The-Penn-State-Behrend-Robotics-Club/ChalkbotMechanical/Chalkbot1.0/Apparatus/V3/Other Docs/Parts and Price List.xlsx

Stepper Apparatus
 | Item | Price/Unit | MIN Req. Units | Total Price | Link | Comments
 | 550 Type III Paracord | $7.02 | 1 | $7.02 | Amazon Basics 550 Type III Paracord, 7-Strand Core, High Strength - 5/32 Inch x 100 Foot (4mm x 30m), Blue - - Amazon.com (https://www.amazon.com/Amazon-Basics-Paracord-7-Strand-Strength/dp/B08HNZCH3Z) | Nothing special about that specific link other than it is cheap. 550 Type III prefered for its dimensions, but it is overkill strength wise. If it can be seen, multiple colors may be fun.
 | 20 Pulleys | $9.71 | 1 | $9.71 | Amazon.com: Chiloskit 20pcs 1.5mm Deep Metal V Groove Guide Pulley Bearing Wheel Rail Ball Bearings Wheel 4x13x6mm : Industrial & Scientific (https://www.amazon.com/gp/product/B012KKTBRU/ref=ppx_yo_dt_b_search_asin_title?ie=UTF8&psc=1) | I already have 20 of these
 | 17HS19-2004S1 59 Ncm NEMA 17 Stepper Motor | $13.99 | 8 | $111.92 | STEPPERONLINE Nema 17 Stepper Motor Bipolar 2A 59Ncm(84oz.in) 48mm Body 4-lead W/ 1m Cable and Connector compatible with 3D Printer/CNC - - Amazon.com (https://www.amazon.com/STEPPERONLINE-Stepper-Bipolar-Connector-compatible/dp/B00PNEQKC0?s=hi) | All testing was done with a 59Ncm stepper. On paper, much less torque is needed (about 10.7 Ncm for pulling NOT HOLDING), but math does not not line up with real world application. May also be cheaper elsewhere.
 | Stepper Motor Drivers (4 pack) | $11.49 | 2 | $22.98 | Amazon.com: HiLetgo 4pcs L298N Motor Driver Controller Board Module Stepper Motor DC Dual H-Bridge for Arduino Smart Car Power UNO MEGA R3 Mega2560 : Industrial & Scientific (https://www.amazon.com/HiLetgo-Controller-Stepper-H-Bridge-Mega2560/dp/B07BK1QL5T?s=industrial) | Don't know if these are best/good, but are what I used. I have 1 pack of 4.
Either | LCF 025 05 031S (1.03 lb CF Spring) | $5.05 | 16 | $80.80 | Search for Constant Force Springs | Lee Spring (https://www.leespring.com/constant-force-springs) | For 2lb writing force. I already have 4 of these.
OR | LCF 040 04 025S (0.5 lb CF Spring) | $5.08 | 16 | $81.28 | Search for Constant Force Springs | Lee Spring (https://www.leespring.com/constant-force-springs) | For 1lb writing force. I already have 4 of these.
OR | LCF 130 06 038S (0.71 lb CF Spring) | $5.83 | 16 | $93.28 | Search for Constant Force Springs | Lee Spring (https://www.leespring.com/constant-force-springs) | For 1.42lb writing force.
OR | LCF 025 05 031S (1.03 lb CF Spring) And LCF 040 04 025S (0.5 lb CF Spring) | $5.06 | 16 | $81.04 | Search for Constant Force Springs | Lee Spring (https://www.leespring.com/constant-force-springs) | Priced out half 1lb and half 0.5 lb. Twisting when combining a 1.03 lb and a 0.5 lb spring is minimal and may be a viable solution if 1.53 lb is desired.
Either | ATOPLEE 10pcs Mini Electromagnetic Solenoid Lock DC 12V Slim Design Cabinet Drawer Lock,27X29X18mm | $39.99 | 1 | $39.99 | ATOPLEE 1pc Mini Electromagnetic Solenoid Lock DC 12V Slim Design Cabinet Drawer Lock,27X29X18mm - - Amazon.com (https://www.amazon.com/gp/product/B01FH5JUD0/ref=ppx_yo_dt_b_asin_title_o07_s00?ie=UTF8&th=1) | We only need 8, so 2 packs of 4 will work. I already have one of these. Essentially the same price as buying a pack of 10 though. I have no idea if 12V or 6V is better for our use, but the way I was powering it, the stepper used too much power to operate the 12V solenoid out of my power regulator.
OR | uxcell DC 6V 1A 6mm Mini Electromagnetic Solenoid Lock Assembly Tongue Up for Electirc Lock Cabinet Door Lock | $13.49 | 8 | $107.92 | uxcell DC 6V 1A 6mm Mini Electromagnetic Solenoid Lock Assembly Tongue Up for Electirc Lock Cabinet Door Lock: Amazon.com: Tools & Home Improvement (https://www.amazon.com/gp/product/B07TMVR312/ref=ppx_yo_dt_b_asin_title_o03_s00?ie=UTF8&psc=1) | I don’t know if we need 6V, but it is way more expensive… I have one of these.
Change to 8 on one board | Relays for Solenoids (10 pack) | $13.99 | 1 | $13.99 | ANMBEST 10PCS 12V Relay Module with Optocoupler High or Low Level Trigger Expansion Board for Raspberry Pi Arduino: Amazon.com: Industrial & Scientific (https://www.amazon.com/ANMBEST-Optocoupler-Trigger-Expansion-Raspberry/dp/B08PNHHC65?s=industrial) | Not sure if these are best. I used one of these or similar. There is also and eight channel one on one board.
 | 1 kg 3D Printer filament spool | $24.99 | 4 probably | #VALUE! | Amazon.com: HATCHBOX 1.75mm Black PLA 3D Printer Filament, 1 KG Spool, Dimensional Accuracy +/- 0.03 mm, 3D Printing Filament : Industrial & Scientific (https://www.amazon.com/dp/B00J0ECR5I) | This one is up to preference and price. Fun colors would be cool. The link is the filament I like, but whatever should work.
 | Total |  |  | $286.65 | not including filament cost, using price for half 1.03 lb and half 0.5 lb springs, and assuming 12V solenoids work.
 | Needs Fasteners
Linear Actuator Apparatus
 | Item | Price/Unit | MIN Req. Units | Total Price | Link | Comments
 | 550 Type III Paracord | $7.02 | 1 | $7.02 | Amazon Basics 550 Type III Paracord, 7-Strand Core, High Strength - 5/32 Inch x 100 Foot (4mm x 30m), Blue - - Amazon.com (https://www.amazon.com/Amazon-Basics-Paracord-7-Strand-Strength/dp/B08HNZCH3Z) | Nothing special about that specific link other than it is cheap. 550 Type III prefered for its dimensions, but it is overkill strength wise. If it can be seen, multiple colors may be fun.
 | UYGALAXY 4" Stroke Micro Electric Linear Actuator 12V - 32N/7.2lb Speed 1.2"/sec Mini Waterproof Metal Mini Motion Actuator with Mounting Bracket for DIY Robot Cabinet Drawer Shutter Cosplay | $39.99 | 8 | $319.92 | UYGALAXY 4" Stroke Micro Electric Linear Actuator 12V - 32N/7.2lb Speed 1.2"/sec Mini Waterproof Metal Mini Motion Actuator with Mounting Bracket for DIY Robot Cabinet Drawer Shutter Cosplay: Amazon.com: Industrial & Scientific (https://www.amazon.com/UYGALAXY-Stroke-Electric-Linear-Actuator/dp/B0B4BHRYMG?s=industrial) | Important part is 4 inch stroke and around 15N. Aavailability may be spotty and prices seem to only go up. Steppers are more consistent in price and stock.
 | Reversing Relays for Linear Actuators | $17.40 | 8 | $139.20 | Forward and Reverse Relay Module for Motor/Linear Actuator, Reversing Relay Module (DC 12V): Amazon.com: Industrial & Scientific (https://www.amazon.com/Forward-Reverse-Module-Actuator-Reversing/dp/B0879GGVPZ?s=industrial) | I have never used these before. There may be a better way.
Either | LCF 025 05 031S (1.03 lb CF Spring) | $5.05 | 16 | $80.80 | Search for Constant Force Springs | Lee Spring (https://www.leespring.com/constant-force-springs) | For 2lb writing force. I already have 4 of these.
OR | LCF 040 04 025S (0.5 lb CF Spring) | $5.08 | 16 | $81.28 | Search for Constant Force Springs | Lee Spring (https://www.leespring.com/constant-force-springs) | For 1lb writing force. I already have 4 of these.
OR | LCF 130 06 038S (0.71 lb CF Spring) | $5.83 | 16 | $93.28 | Search for Constant Force Springs | Lee Spring (https://www.leespring.com/constant-force-springs) | For 1.42lb writing force.
OR | LCF 025 05 031S (1.03 lb CF Spring) And LCF 040 04 025S (0.5 lb CF Spring) | $5.06 | 16 | $81.04 | Search for Constant Force Springs | Lee Spring (https://www.leespring.com/constant-force-springs) | Priced out half 1lb and half 0.5 lb. Twisting when combining a 1.03 lb and a 0.5 lb spring is minimal and may be a viable solution if 1.53 lb is desired.
 | 1 kg 3D Printer filament spool | $24.99 | 4 probably | #VALUE! | Amazon.com: HATCHBOX 1.75mm Black PLA 3D Printer Filament, 1 KG Spool, Dimensional Accuracy +/- 0.03 mm, 3D Printing Filament : Industrial & Scientific (https://www.amazon.com/dp/B00J0ECR5I) | This one is up to preference and price. Fun colors would be cool. The link is the filament I like, but whatever should work.
 | Total |  |  | $547.18 | Not including filament and using AVG price for 0.5 lb and 1.03 lb springs
ALSO | Item | Price/Unit | MIN Req. Units | Total Price | Link | Comments
 | 0.49 lb Springs McMaster-Carr 9293K112 | $7.63 | 16 | $122.08 | https://www.mcmaster.com/9293K112/ | In case Lee Springs doesn’t work for whatever reason. These will most likely require a slight redesign
 | 1.03 lb Springs McMaster-Carr 9293K44 | $9 | 16 | $144 | https://www.mcmaster.com/9293K44/ | In case Lee Springs doesn’t work for whatever reason. These will require a slight redesign
