The-Penn-State-Behrend-Robotics-Club/ChalkbotMechanical/Chalkbot1.0/Apparatus/Collet Tests/Collet Ring for Strong Collet V2.stl

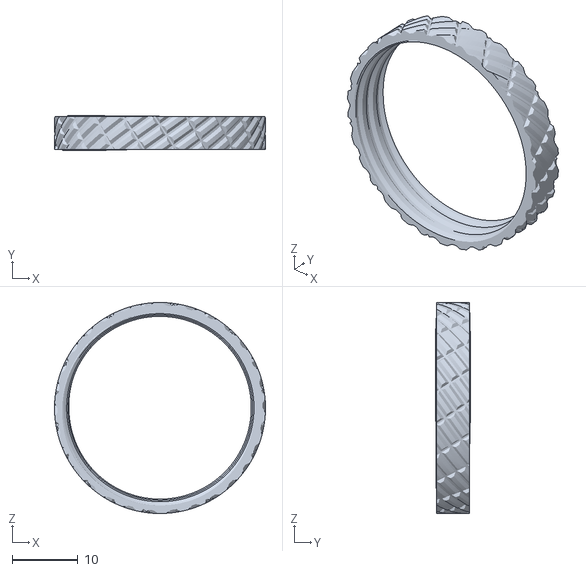
[picture p1: CAD file, 2023-05-26]
Chalkbot1.0/Apparatus/Collet Tests/Collet Ring for Strong Collet V2.stl
32.2 x 5.36 x 32.2
