The-Penn-State-Behrend-Robotics-Club/ChalkbotMechanical/Chalkbot1.0/Chassis/V1/Bearing Press Fit Test -0.01.stl

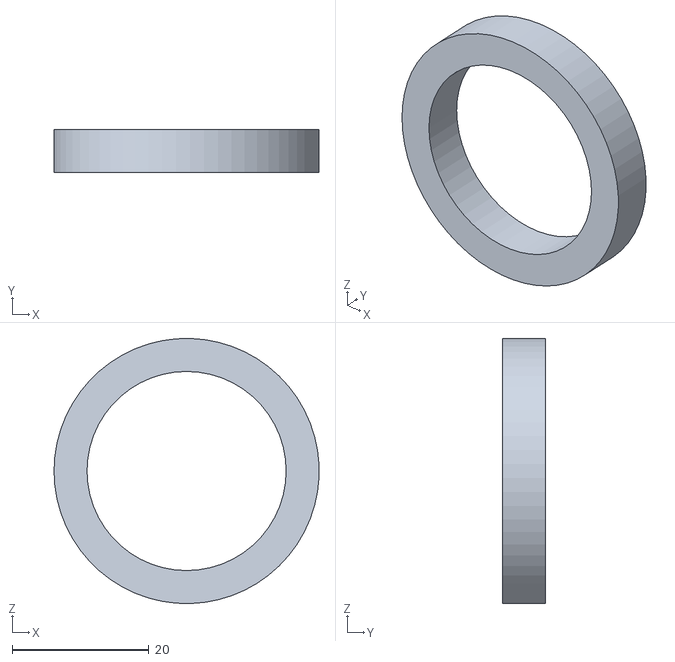
[picture p2: CAD file, 2023-11-30]
Chalkbot1.0/Chassis/V1/Bearing Press Fit Test -0.01.stl
38.7 x 6.35 x 38.7
