The-Penn-State-Behrend-Robotics-Club/ChalkbotMechanical/Chalkbot1.0/Chassis/V1/Mechanum STEP files/am-3918L 4HD 500H Mecanum Left.STEP

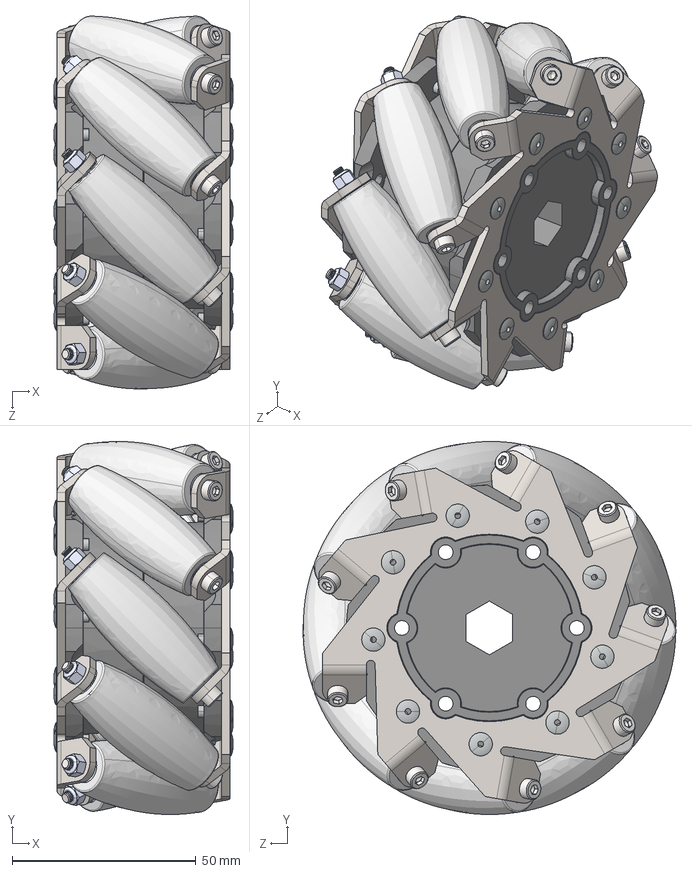
[picture p3: CAD file, 2023-05-26]
Chalkbot1.0/Chassis/V1/Mechanum STEP files/am-3918L 4HD 500H Mecanum Left.STEP
48.7 x 101.6 x 101.5 mm
ip-3xxx_half 4HD 500H Mecanum Hub x 2
125 rivet x 18
Brass tube x 9
ip-3026L_plate 4 HD Left Mecanum Plate_DefaultSM-FLAT-PATTERN x 2
4HD Mecanum Roller Core x 9
4HD Mecanum roller skin x 9
SHCS M3 x 55mm_B18.3.1M - 3 x 0.5 x 55 Hex SHCS -- 18SHX x 9
M3 x 0.5 Nylock Nut x 9
