The-Penn-State-Behrend-Robotics-Club/ChalkbotMechanical/Chalkbot1.0/Chassis/V1/Motor and Gearbox STEP files/am-2986 FR8ZZ Hex Bearing.STEP

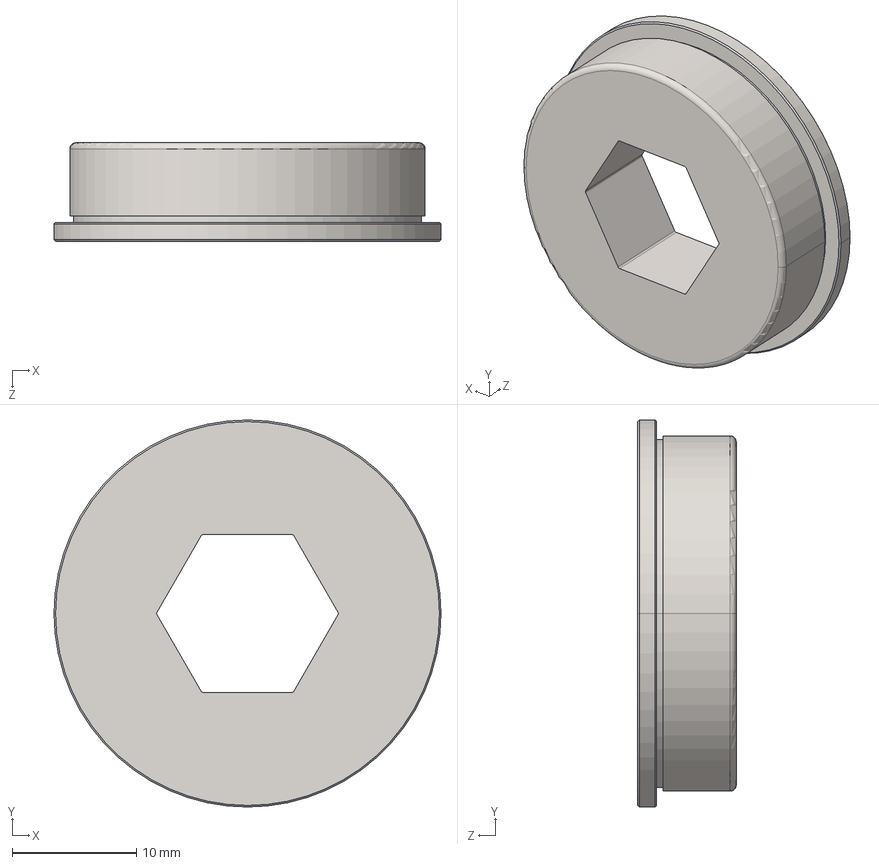
[picture p4: CAD file, 2023-10-26]
Chalkbot1.0/Chassis/V1/Motor and Gearbox STEP files/am-2986 FR8ZZ Hex Bearing.STEP
31.1 x 31.1 x 7.93 mm
