The-Penn-State-Behrend-Robotics-Club/ChalkbotMechanical/Chalkbot1.0/Printplz/Spring Shafts.stl

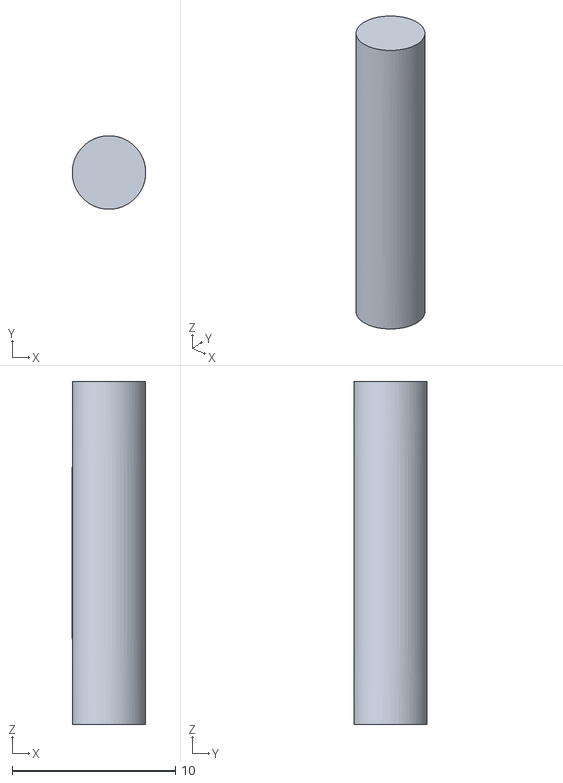
[picture p5: CAD file, 2023-05-26]
Chalkbot1.0/Printplz/Spring Shafts.stl
4.50 x 4.50 x 21.0
