The-Penn-State-Behrend-Robotics-Club/ChalkbotMechanical/Chalkbot1.0/Printplz/Slider V10 (2mm pitch).stl

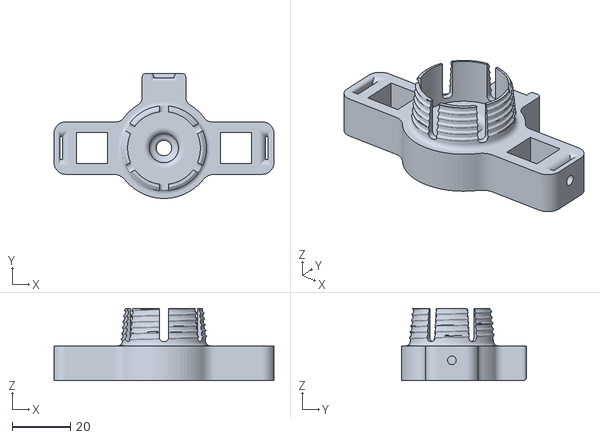
[picture p8: CAD file, 2023-05-26]
Chalkbot1.0/Printplz/Slider V10 (2mm pitch).stl
75.5 x 42.9 x 24.9
