The-Penn-State-Behrend-Robotics-Club/ChalkbotMechanical/Chalkbot1.0/Apparatus/Collet Tests/Strong Collet V1.stl

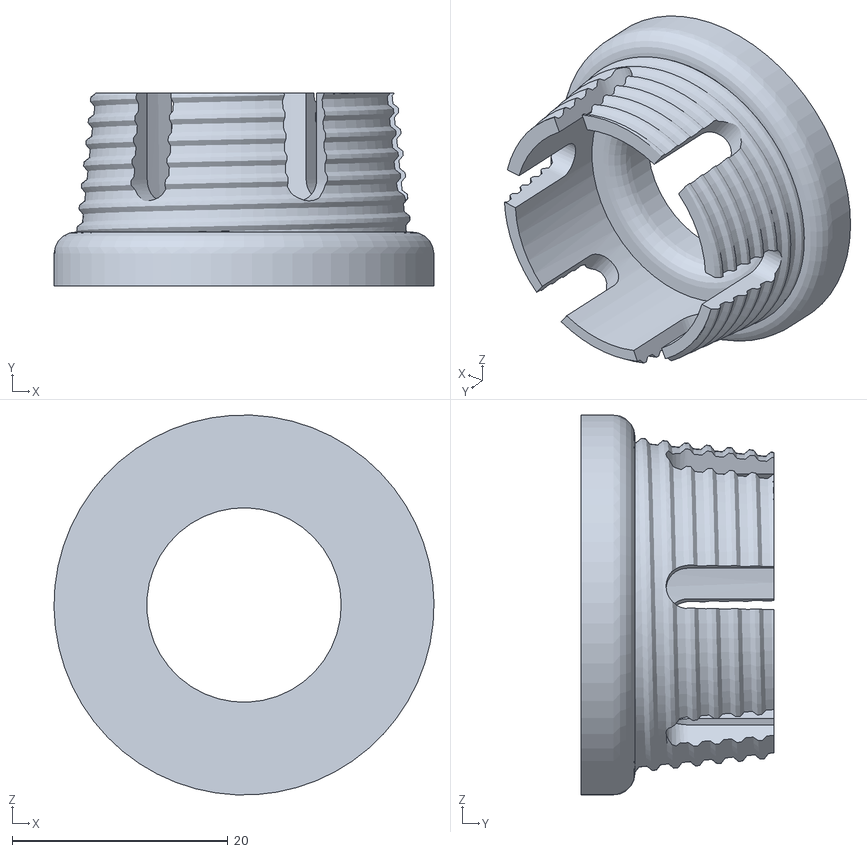
[picture p9: CAD file, 2023-05-26]
Chalkbot1.0/Apparatus/Collet Tests/Strong Collet V1.stl
35.2 x 17.9 x 35.2
