The-Penn-State-Behrend-Robotics-Club/ChalkbotMechanical/Chalkbot1.0/Chassis/V1/Shaft Spacers.stl

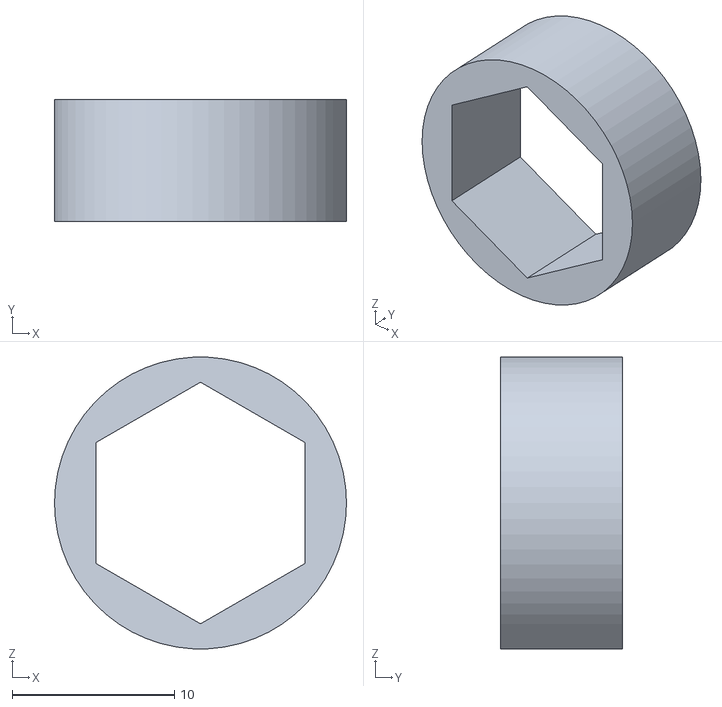
[picture p11: CAD file, 2023-05-26]
Chalkbot1.0/Chassis/V1/Shaft Spacers.stl
18.0 x 7.50 x 18.0
