The-Penn-State-Behrend-Robotics-Club/ChalkbotMechanical/Chalkbot1.0/Chassis/V1/Motor and Gearbox STEP files/am-3775a AndyMark RedLine Motor (1).STEP

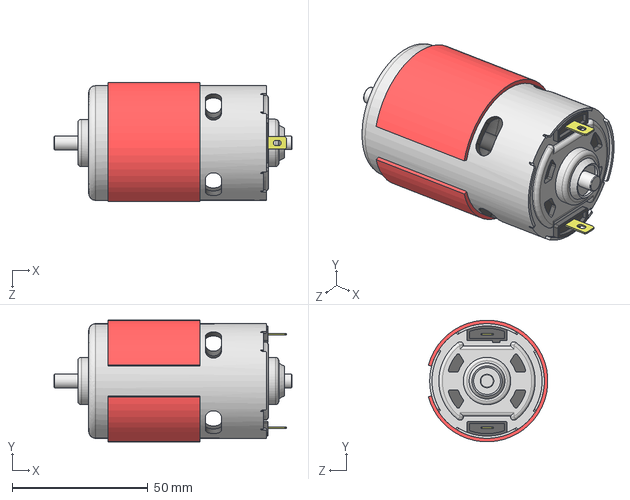
[picture p12: CAD file, 2023-05-26]
Chalkbot1.0/Chassis/V1/Motor and Gearbox STEP files/am-3775a AndyMark RedLine Motor (1).STEP
87.7 x 44.8 x 44.0 mm
