The-Penn-State-Behrend-Robotics-Club/ChalkbotMechanical/Chalkbot1.0/Chassis/V1/Shaft support.stl

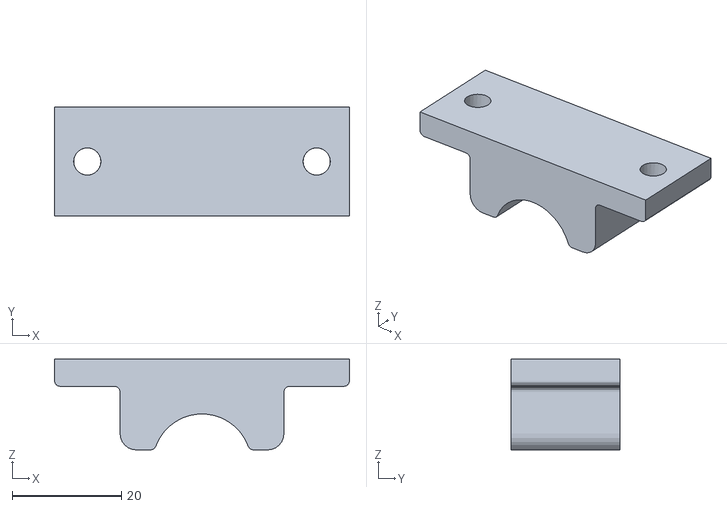
[picture p13: CAD file, 2023-05-26]
Chalkbot1.0/Chassis/V1/Shaft support.stl
54.0 x 20.0 x 16.6
