The-Penn-State-Behrend-Robotics-Club/ChalkbotMechanical/Chalkbot1.0/Chassis/V1/Motor and Gearbox STEP files/2 Stage HD - 57 Sport.STEP

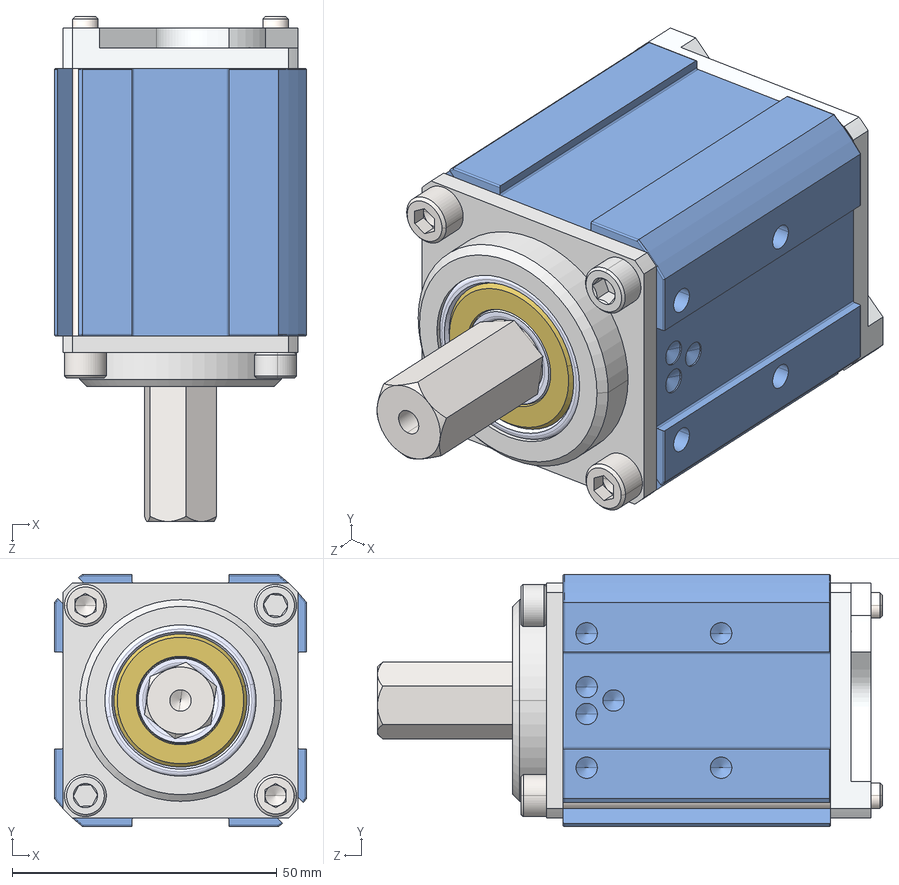
[picture p14: CAD file, 2023-05-26]
Chalkbot1.0/Chassis/V1/Motor and Gearbox STEP files/2 Stage HD - 57 Sport.STEP
47.6 x 47.6 x 95.4 mm
am-XXXX - 57 Sport 500 Hex Shaft
Output Block
retaining Ring 0500 - Mcm 98410A122_98410A122
R8ZZ Bearing x 2
Thrust washer - 775 Sport
10-32 X 375 SHCS_90128A940 x 2
5_1 HD Output Stage Carrier Plate
18T Long Planet Gear x 4
am-XXXX - 57 Sport Stage Carrier Plate
16T Long Sun Gear x 2
16T Planet Gear x 4
am-XXXX - 57 Sport 2 Stage HD Ring Gear Housing
10-32x2500_shcs 2_HX-SHCS 0.19-32x1.375x1-C x 2
am-XXXX - 57 Sport Motor Block
