The-Penn-State-Behrend-Robotics-Club/ChalkbotMechanical/Chalkbot1.0/Chassis/V1/Motor Mounts.stl

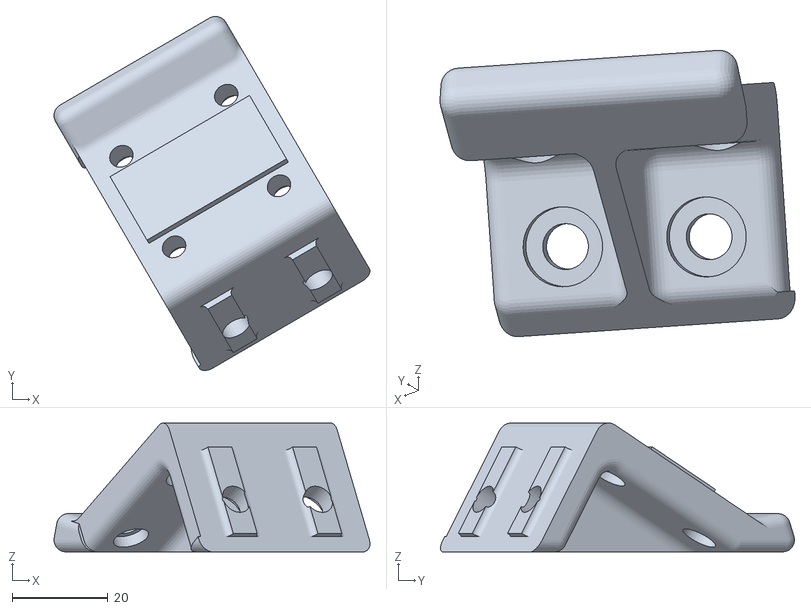
[picture p15: CAD file, 2023-05-26]
Chalkbot1.0/Chassis/V1/Motor Mounts.stl
66.1 x 74.1 x 27.0
