The-Penn-State-Behrend-Robotics-Club/ChalkbotMechanical/Chalkbot1.0/Chassis/V1/End Shaft Spacers.stl

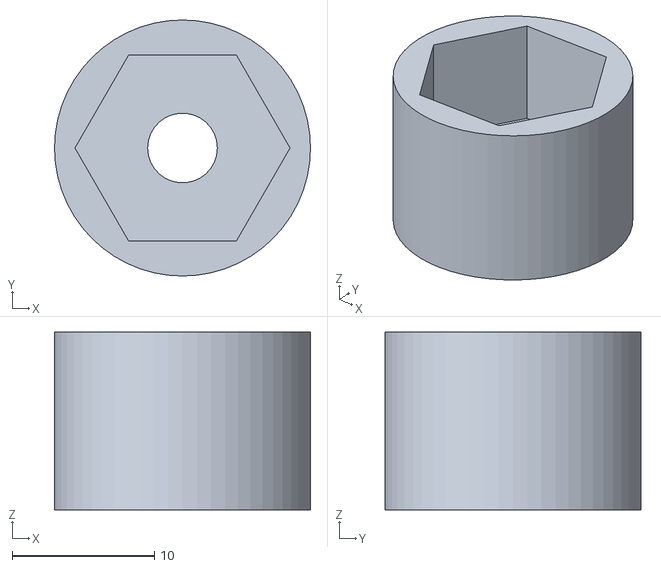
[picture p16: CAD file, 2023-05-26]
Chalkbot1.0/Chassis/V1/End Shaft Spacers.stl
18.0 x 18.0 x 12.5
