The-Penn-State-Behrend-Robotics-Club/ChalkbotMechanical/(list of files, cad)

Other CAD files:
Chalkbot1.0/Chassis/V1/Bearing Press Fit Test -0.005.stl
Chalkbot1.0/Chassis/V1/BasePlate-1.dwg
Chalkbot1.0/Apparatus/Collet Tests/Collet Ring for Strong Collet V1.ipt
Chalkbot1.0/Apparatus/Collet Tests/Collet Ring for Strong Collet V1.stl
Chalkbot1.0/Apparatus/Collet Tests/OldVersions/Collet Ring for Strong Collet V1.0004.ipt
Chalkbot1.0/Apparatus/Collet Tests/OldVersions/Strong Collet V1.0001.ipt
Chalkbot1.0/Apparatus/Collet Tests/Strong Collet V1.ipt
Chalkbot1.0/Apparatus/V1/Apparatus Assembly V2.iam
Chalkbot1.0/Apparatus/V1/Chalk Holder.ipt
Chalkbot1.0/Apparatus/V1/Chalk.ipt
Chalkbot1.0/Apparatus/V1/Screw.ipt
Chalkbot1.0/Apparatus/V1/Sheath.ipt
Chalkbot1.0/Apparatus/V2 (CF Spring)/CF Spring with hole.ipt
Chalkbot1.0/Apparatus/V2 (CF Spring)/Cap V2 (App V5).ipt
Chalkbot1.0/Apparatus/V2 (CF Spring)/Chalk.ipt
Chalkbot1.0/Apparatus/V2 (CF Spring)/Slider V4-2 (spring with hole).ipt
Chalkbot1.0/Apparatus/V2 (CF Spring)/Spring apparatus V5.ipt
Chalkbot1.0/Apparatus/V2 (CF Spring)/Spring apparatus assembly V2.iam
Chalkbot1.0/Apparatus/V3.1/Assembly1.iam
Chalkbot1.0/Apparatus/V3.1/Assembly2.iam
Chalkbot1.0/Apparatus/V3.1/Lever Arm.ipt
Chalkbot1.0/Apparatus/V3.1/Locker.ipt
Chalkbot1.0/Apparatus/V3.1/OldVersions/Assembly1.0001.iam
Chalkbot1.0/Apparatus/V3.1/OldVersions/Assembly2.0005.iam
Chalkbot1.0/Apparatus/V3.1/OldVersions/Lever Arm.0001.ipt
Chalkbot1.0/Apparatus/V3.1/OldVersions/Locker.0002.ipt
Chalkbot1.0/Apparatus/V3.1/OldVersions/Plunger Cap.0008.ipt
Chalkbot1.0/Apparatus/V3.1/OldVersions/Plunger.0004.ipt
Chalkbot1.0/Apparatus/V3.1/OldVersions/Slider.0007.ipt
Chalkbot1.0/Apparatus/V3.1/OldVersions/Slider2.0005.ipt
Chalkbot1.0/Apparatus/V3.1/OldVersions/Support Hole.0003.ipt
Chalkbot1.0/Apparatus/V3.1/OldVersions/Tensioner.0001.ipt
Chalkbot1.0/Apparatus/V3.1/OldVersions/Tensioner2.0003.ipt
Chalkbot1.0/Apparatus/V3.1/Plunger Cap.ipt
Chalkbot1.0/Apparatus/V3.1/Plunger.ipt
Chalkbot1.0/Apparatus/V3.1/Slider.ipt
Chalkbot1.0/Apparatus/V3.1/Slider2.ipt
Chalkbot1.0/Apparatus/V3.1/Support Hole.ipt
Chalkbot1.0/Apparatus/V3.1/Tensioner.ipt
Chalkbot1.0/Apparatus/V3.1/Tensioner2.ipt
Chalkbot1.0/Apparatus/V3.2/Bolt Head.ipt
Chalkbot1.0/Apparatus/V3.2/Bolt Head.stl
Chalkbot1.0/Apparatus/V3.2/Locker Assembly.iam
Chalkbot1.0/Apparatus/V3.2/Locker Assembly2.iam
Chalkbot1.0/Apparatus/V3.2/OldVersions/Bolt Head.0001.ipt
Chalkbot1.0/Apparatus/V3.2/OldVersions/Locker Assembly.0003.iam
Chalkbot1.0/Apparatus/V3.2/OldVersions/Pin.0001.ipt
Chalkbot1.0/Apparatus/V3.2/OldVersions/Plunger Cap.0001.ipt
Chalkbot1.0/Apparatus/V3.2/OldVersions/R2.0005.ipt
Chalkbot1.0/Apparatus/V3.2/OldVersions/R3.0003.ipt
Chalkbot1.0/Apparatus/V3.2/OldVersions/Slider For Bolt.0003.ipt
Chalkbot1.0/Apparatus/V3.2/OldVersions/Slider.0006.ipt
Chalkbot1.0/Apparatus/V3.2/OldVersions/r4.0005.ipt
Chalkbot1.0/Apparatus/V3.2/Pin.ipt
Chalkbot1.0/Apparatus/V3.2/Pin.stl
Chalkbot1.0/Apparatus/V3.2/Plunger Cap.ipt
Chalkbot1.0/Apparatus/V3.2/Plunger Cap.stl
Chalkbot1.0/Apparatus/V3.2/R2.ipt
Chalkbot1.0/Apparatus/V3.2/R2.stl
Chalkbot1.0/Apparatus/V3.2/R3.ipt
Chalkbot1.0/Apparatus/V3.2/R3.stl
Chalkbot1.0/Apparatus/V3.2/Slider For Bolt.ipt
Chalkbot1.0/Apparatus/V3.2/Slider For Bolt.stl
Chalkbot1.0/Apparatus/V3.2/Slider.ipt
Chalkbot1.0/Apparatus/V3.2/Slider.stl
Chalkbot1.0/Apparatus/V3.2/r4.ipt
Chalkbot1.0/Apparatus/V3.2/r4.stl
Chalkbot1.0/Apparatus/V3/Apparatus Collet V6 CF Springs.ipt
Chalkbot1.0/Apparatus/V3/Apparatus Master Assembly V1.iam
Chalkbot1.0/Apparatus/V3/Cap and Cap Rope Guide/Cap Pulley Support Shaft V1.ipt
Chalkbot1.0/Apparatus/V3/Cap and Cap Rope Guide/Cap Pulley Support V2 Pt1.ipt
Chalkbot1.0/Apparatus/V3/Cap and Cap Rope Guide/Cap Pulley Support V2 Pt2.ipt
Chalkbot1.0/Apparatus/V3/Cap and Cap Rope Guide/Cap V7 (Collet App).ipt
Chalkbot1.0/Apparatus/V3/Cap and Cap Rope Guide/Cap V7 (Stepper Mount).ipt
Chalkbot1.0/Apparatus/V3/Cap and Cap Rope Guide/Cap V8 (Stepper Mount).ipt
Chalkbot1.0/Apparatus/V3/Cap and Cap Rope Guide/OldVersions/Cap V7 (Stepper Mount).0003.ipt
Chalkbot1.0/Apparatus/V3/Cap and Cap Rope Guide/OldVersions/Cap V8 (Stepper Mount).0001.ipt
Chalkbot1.0/Apparatus/V3/Chalk Holder/Collet Ring V5 (2mm p).ipt
Chalkbot1.0/Apparatus/V3/Chalk Holder/Collet Ring V5 (4mm p).ipt
Chalkbot1.0/Apparatus/V3/Chalk Holder/Collet Ring V5.1 (2mm p).ipt
Chalkbot1.0/Apparatus/V3/Chalk Holder/Collet Ring V5.2 (2mm p).ipt
Chalkbot1.0/Apparatus/V3/Chalk Holder/Collet Ring V6 (4mm p).ipt
Chalkbot1.0/Apparatus/V3/Chalk Holder/OldVersions/Slider V8 (4mm pitch).0008.ipt
Chalkbot1.0/Apparatus/V3/Chalk Holder/OldVersions/Slider V9 (Accessible Collet).0001.ipt
Chalkbot1.0/Apparatus/V3/Chalk Holder/Slider V8 (2mm pitch).ipt
Chalkbot1.0/Apparatus/V3/Chalk Holder/Slider V8 (4mm pitch).ipt
Chalkbot1.0/Apparatus/V3/Chalk Holder/Slider V9 (Accessible Collet).ipt
Chalkbot1.0/Apparatus/V3/OldVersions/Apparatus Collet V6 CF Springs.0007.ipt
Chalkbot1.0/Apparatus/V3/OldVersions/Apparatus Master Assembly V1.0023.iam
Chalkbot1.0/Apparatus/V3/Purchased Parts/17HS19-2004S1.ipt
Chalkbot1.0/Apparatus/V3/Purchased Parts/Chalk.ipt
Chalkbot1.0/Apparatus/V3/Purchased Parts/LCF 025 05 031S (on hub).ipt
Chalkbot1.0/Apparatus/V3/Purchased Parts/Rope Bearing Pulley.ipt
Chalkbot1.0/Apparatus/V3/Purchased Parts/Solenoid Lock.ipt
Chalkbot1.0/Apparatus/V3/Spring Hubs and Shafts/1lb CF Spring Hub V1.ipt
Chalkbot1.0/Apparatus/V3/Spring Hubs and Shafts/CF Spring Shaft V1.ipt
Chalkbot1.0/Apparatus/V3/Spring Hubs and Shafts/OldVersions/1lb CF Spring Hub V1.0005.ipt
Chalkbot1.0/Apparatus/V3/Stepper Attachments/OldVersions/Stepper Mount V4.0004.ipt
Chalkbot1.0/Apparatus/V3/Stepper Attachments/OldVersions/Stepper Pulley V12.0006.ipt
Chalkbot1.0/Apparatus/V3/Stepper Attachments/OldVersions/Stepper Pulley V14.0002.ipt
Chalkbot1.0/Apparatus/V3/Stepper Attachments/Rope Guide V5.ipt
Chalkbot1.0/Apparatus/V3/Stepper Attachments/Stepper Mount V4.ipt
Chalkbot1.0/Apparatus/V3/Stepper Attachments/Stepper Pulley V12.ipt
Chalkbot1.0/Apparatus/V3/Stepper Attachments/Stepper Pulley V14.ipt
Chalkbot1.0/Apparatus/V4/Apparatus Master Assem V4.1.iam
Chalkbot1.0/Apparatus/V4/Apparatus Master Assem V4.iam
Chalkbot1.0/Apparatus/V4/Cap for Tower pt2.ipt
Chalkbot1.0/Apparatus/V4/Cap for Tower pt2.stl
Chalkbot1.0/Apparatus/V4/LCF 040 04 025S (on 10.35mm hub).ipt
Chalkbot1.0/Apparatus/V4/OldVersions/Apparatus Master Assem V4.0001.iam
Chalkbot1.0/Apparatus/V4/OldVersions/Apparatus Master Assem V4.1.0004.iam
Chalkbot1.0/Apparatus/V4/OldVersions/Cap for Tower pt2.0005.ipt
Chalkbot1.0/Apparatus/V4/OldVersions/Slider V9 (2mm pitch).0006.ipt
Chalkbot1.0/Apparatus/V4/OldVersions/Slider V9 (4mm pitch).0003.ipt
Chalkbot1.0/Apparatus/V4/OldVersions/Tower pt2.0012.ipt
Chalkbot1.0/Apparatus/V4/OldVersions/Tower.0005.ipt
Chalkbot1.0/Apparatus/V4/PI3MK3M_Tower.3mf
Chalkbot1.0/Apparatus/V4/Slider V9 (2mm pitch).ipt
Chalkbot1.0/Apparatus/V4/Slider V9 (2mm pitch).stl
Chalkbot1.0/Apparatus/V4/Slider V9 (4mm pitch).ipt
Chalkbot1.0/Apparatus/V4/Slider V9 (4mm pitch).stl
Chalkbot1.0/Apparatus/V4/Tower pt2.ipt
Chalkbot1.0/Apparatus/V4/Tower pt2.stl
Chalkbot1.0/Apparatus/V4/Tower.ipt
Chalkbot1.0/Apparatus/V4/Tower.stl
Chalkbot1.0/Apparatus/V5/3D prints/Assembly1.stl
Chalkbot1.0/Apparatus/V5/3D prints/Base.stl
Chalkbot1.0/Apparatus/V5/3D prints/Collet Ring V10 Knurled (2mm p).stl
Chalkbot1.0/Apparatus/V5/3D prints/Collet Ring V11 Knurled (2mm p).stl
Chalkbot1.0/Apparatus/V5/3D prints/Collet Ring V5 Ridged (2mm p).stl
Chalkbot1.0/Apparatus/V5/3D prints/Collet Ring V5.4 (2mm p).stl
Chalkbot1.0/Apparatus/V5/3D prints/Collet Ring V6 Knurled (2mm p).stl
Chalkbot1.0/Apparatus/V5/3D prints/Collet Ring V6 Ridged (2mm p).stl
Chalkbot1.0/Apparatus/V5/3D prints/Collet Ring V7 Knurled (2mm p).stl
Chalkbot1.0/Apparatus/V5/3D prints/Collet Ring V8 Knurled (2mm p).stl
Chalkbot1.0/Apparatus/V5/3D prints/Collet Ring V9 Knurled (2mm p).stl
Chalkbot1.0/Apparatus/V5/3D prints/Slider V10 (2mm pitch).stl
Chalkbot1.0/Apparatus/V5/3D prints/Slider V9 (4mm pitch) Flexure.stl
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
