The-Penn-State-Behrend-Robotics-Club/ChalkbotMechanical/Chalkbot1.0/Chassis/V1/BasePlate-1.pdf

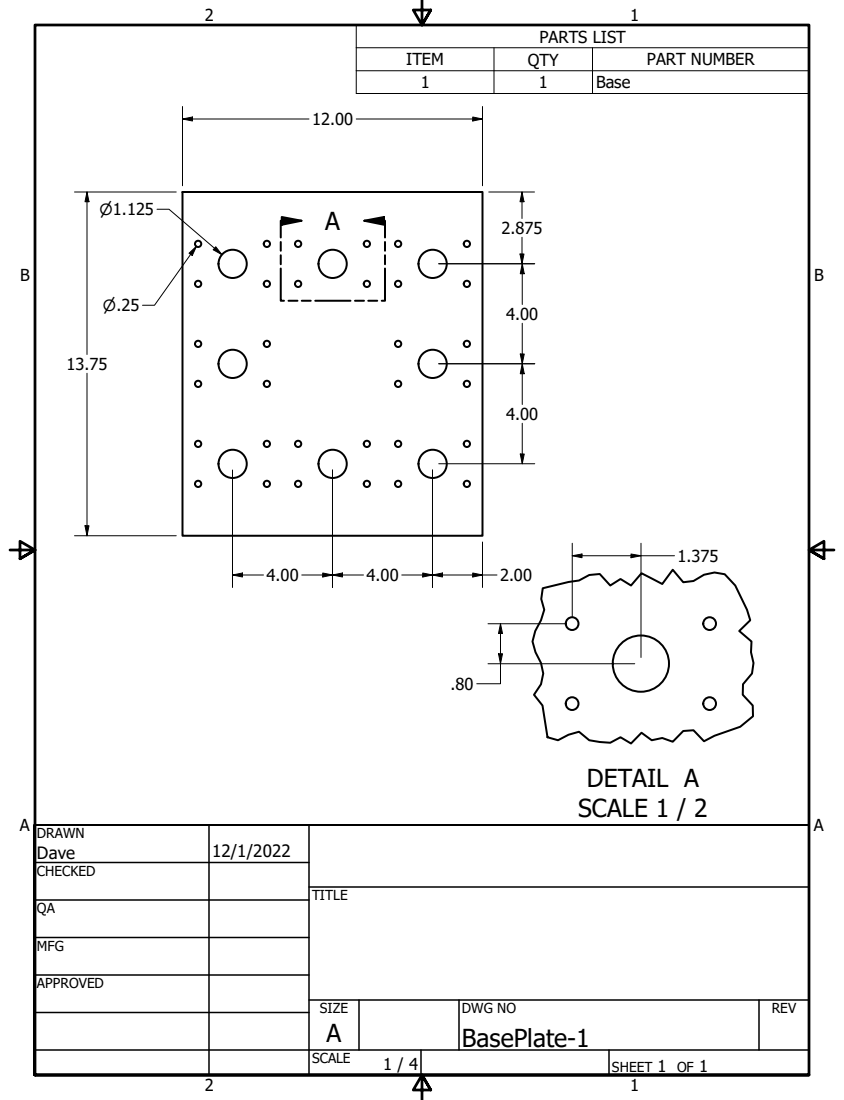
[picture p17: page 1]
DETAIL A SCALE 1 / 2

PARTS LIST

ITEM | QTY | PART NUMBER
1 | 1 | Base

DRAWN Dave | 12/1/2022

CHECKED

MFG

APPROVED

SIZE A | DWG NO BasePlate-1 | REV

SCALE 1 / 4 | | SHEET 1 OF 1
