The-Penn-State-Behrend-Robotics-Club/ChalkbotMechanical/Chalkbot1.0/Apparatus/V3/Other Docs/Steps to mm.xlsx

1.8 | Step angle (degrees) |  | 0.3769911184 | Arc length
200 | steps per rotation
12 | Pulley radius (mm) |  | 241.384997 | Minimum steps
91 | Min Retraction height (mm)
 | Height | Steps
 | 2 | 5.30516477
 | 4 | 10.61032954
 | 6 | 15.91549431
 | 8 | 21.22065908
 | 10 | 26.52582385
 | 12 | 31.83098862
 | 14 | 37.13615339
 | 16 | 42.44131816
 | 18 | 47.74648293
 | 20 | 53.0516477
 | 22 | 58.35681247
 | 24 | 63.66197724
 | 26 | 68.96714201
 | 28 | 74.27230678
 | 30 | 79.57747155
 | 32 | 84.88263632
 | 34 | 90.18780109
 | 36 | 95.49296586
 | 38 | 100.7981306
 | 40 | 106.1032954
 | 42 | 111.4084602
 | 44 | 116.7136249
 | 46 | 122.0187897
 | 48 | 127.3239545
 | 50 | 132.6291192
