The-Penn-State-Behrend-Robotics-Club/ChalkbotMechanical/Chalkbot1.0/Apparatus/V3/Other Docs/Chalk Measurements.xlsx

Peice | Diameter (mm) |  | avg at base | STD dev base
1 | 23.77 | #NAME? | 24.11333333 | 0.2995923156
 | 23.4 | #NAME?
 | 23.05 |  | avg at tip
 | 22.5 |  | 21.86666667
 | 21.82
2 | 24.5 |  | overall avg
 | 23.4 |  | 22.95142857
 | 22.7
 | 22.04
3 | 24.07
 | 23.33 |  | avg at base (in.)
 | 22.77 |  | 0.949343832
 | 22.23
 | 21.74
