The-Penn-State-Behrend-Robotics-Club/ChalkbotMechanical/(commit log)

2023-05-26 Initial transfer from GrabCAD
    [1 Stage SD - 57 Sport.0002.iam, 1 Stage SD - 57 Sport.STEP, 1 Stage SD - 57 Sport.iam, 10-32 X 375 SHCS_90128A940.ipt, 10-32 x 1.750 SHCS_90128A953.ipt, 125 rivet.0001.ipt, 125 rivet.ipt, 16T Planet Gear.ipt]
2023-09-20 Add files via upload
    The support part for the controls panels. Formerly named "piece of shit 7".
    [Controls Support.ipt]
2023-10-24 Minor Assembly Updates
    Assembly partially updated, Shaft spacers updated
    [20x20 Channel-560.0011.ipt, 20x20 Channel-560.0012.ipt, 20x20 Channel-560.ipt, 20x20 Channel-600.0012.ipt, 20x20 Channel-600.0013.ipt, 20x20 Channel-600.ipt, 20x20 Channel.0007.ipt, 20x20 Channel.0009.ipt]
2023-10-26 Assembly Updates
    Modified assembly files
    [20x20 90 Gusset_MIR.ipt, 20x20 90 Gusset_MIR1.ipt, 20x20 90 Gusset_MIR_MIR.ipt, 20x20 Channel-550.0001.ipt, 20x20 Channel-550.ipt, 20x20 Channel-600.0013.ipt, 20x20 Channel-600.0014.ipt, 20x20 Channel-600.ipt]
2023-10-26 Assembly updates again lol
    Chassis with wheels in correct locations
    [125 rivet.0001.ipt, 125 rivet.0003.ipt, 125 rivet.ipt, 125 rivet_MIR.ipt, 125 rivet_MIR1.ipt, 2 Stage HD - 57 Sport.0002.ipt, 2 Stage HD - 57 Sport.ipt, 2 Stage HD - 57 Sport_MIR.ipt]
2023-10-26 Better Assembly Update
    [20x20 90 Gusset.0002.ipt, 20x20 90 Gusset.0003.ipt, 20x20 90 Gusset.ipt, 20x20 90 Gusset_MIR1.ipt, Chassis-SubAssem01.0005.iam, Chassis-SubAssem01.0006.iam, Chassis-SubAssem01.iam, LeftMecanum-SubAssem01.0014.iam]
2023-11-02 Slider V6 Start
    Started modelling Slider V6 collet
    [Slider V6.0005.ipt, Slider V6.ipt]
2023-11-30 Bearing fits for slider and wheels. Also center controls mount
    [Apparati Bearing Fit Test -0.005.0002.ipt, Apparati Bearing Fit Test -0.005.ipt, Apparati Bearing Fit Test -0.005.stl, Apparati Bearing Fit Test -0.0075.stl, Apparati Bearing Fit Test -0.01.0001.ipt, Apparati Bearing Fit Test -0.01.ipt, Apparati Bearing Fit Test -0.01.stl, Ball 1in.0001.ipt]
2023-11-30 Pillow Block Update
    [LeftMecanum-SubAssem01.0015.iam, LeftMecanum-SubAssem01.0018.iam, LeftMecanum-SubAssem01.iam, Pillow RevB.ipt]
2023-11-30 Slider and Base V6 updates
    [Base V6.ipt, Slider V6.0005.ipt, Slider V6.0006.ipt, Slider V6.ipt]
2024-01-12 Slider and Collet Ring V6
    [Slider V6.0006.ipt, Slider V6.0010.ipt, Slider V6.ipt]
2024-01-13 Designed Top V6, Assembly V6, and added spring holes for Slider
    [ApparatusMasterAssemV5.0009.iam, ApparatusMasterAssemV5.0010.iam, ApparatusMasterAssemV5.iam, Master Assembly V6.0003.iam, Master Assembly V6.iam, Rods.ipt, Slider V6.0010.ipt, Slider V6.0012.ipt]
2024-01-13 Added Cash's base and added set screw holes
    [8 Apparati V6.0001.iam, 8 Apparati V6.iam, Base V6.0010.ipt, Base V6.ipt, Master Assembly V6.0003.iam, Master Assembly V6.0005.iam, Master Assembly V6.iam, Slider V6.0012.ipt]
2024-01-25 Slider iterations
    [Base V6.0010.ipt, Base V6.0014.ipt, Base V6.ipt, Master Assembly V6.0005.iam, Master Assembly V6.0007.iam, Master Assembly V6.iam, Slider V6 0.05.ipt, Slider V6 0.1.0004.ipt]
2024-01-26 Make motor controller mount
    [Motor Controller Mount.0001.ipt, Motor Controller Mount.ipt]
2024-02-01 Updated insert hole diam
    Increased insert hole diameter from 6 to 6.2 mm to reflect new heated inserts on top and base
    [Base V6.0014.ipt, Base V6.0015.ipt, Base V6.ipt, Motor Controller Mount.0001.ipt, Motor Controller Mount.0002.ipt, Motor Controller Mount.ipt, Top V6.0011.ipt, Top V6.0012.ipt]
2024-02-03 Updates to Top for limit switch
    Added CAD file for limit switch rod bearings and modified the top to fit the limit switch. Also some minor apparatus assy changes
    [6389K231_Light Duty Dry-Running Nylon Sleeve Bearing (1).STEP, 6389K231_Light Duty Dry-Running Nylon Sleeve Bearing (1).ipt, Master Assembly V6.0007.iam, Master Assembly V6.0014.iam, Master Assembly V6.iam, SS0750302F035S1A (Limit Switch).0004.ipt, SS0750302F035S1A (Limit Switch).ipt, Solenoid Spacer.0001.ipt]
2024-02-09 Controls support updates
    [Controls Mid Support.0003.ipt, Controls Mid Support.0004.ipt, Controls Mid Support.ipt, Controls Support V2.0004.ipt, Controls Support V2.ipt, Controls Support V2_MIR.0001.ipt, Controls Support V2_MIR.ipt]
2024-02-13 Made Controls mount V3
    Thinned Controls mount
    [Controls Support V2.0004.ipt, Controls Support V2.0005.ipt, Controls Support V2.ipt, Controls Support V3.0006.ipt, Controls Support V3.ipt, Controls Support V3_MIR.0001.ipt, Controls Support V3_MIR.ipt]
2024-02-13 Further Slimmed Controls Support
    And some other aesthetic. Also a structural support for center where controls panel bolts to mount
    [Controls Support V3.0006.ipt, Controls Support V3.0009.ipt, Controls Support V3.ipt, Controls Support V3_MIR.0001.ipt, Controls Support V3_MIR.0002.ipt, Controls Support V3_MIR.ipt]
2024-02-14 more updates for controls support
    oo shiny
    [Controls Support V3.0009.ipt, Controls Support V3.0011.ipt, Controls Support V3.ipt, Controls Support V3_MIR.0002.ipt, Controls Support V3_MIR.0003.ipt, Controls Support V3_MIR.ipt]
2024-02-16 Updates to center support
    [Controls Mid Support V2.0001.ipt, Controls Mid Support V2.ipt, Controls Support V3.0011.ipt, Controls Support V3.0012.ipt, Controls Support V3.ipt]
2024-03-23 Made Top V7
    [Base V6.0015.ipt, Base V6.0016.ipt, Base V6.ipt, Controls Mid Support V2.0001.ipt, Controls Mid Support V2.0002.ipt, Controls Mid Support V2.ipt, Controls Support V3.0012.ipt, Controls Support V3.0013.ipt]
